AdrianMolecule/inoculatingRobot/documentation/loopHolderParts2.jpg

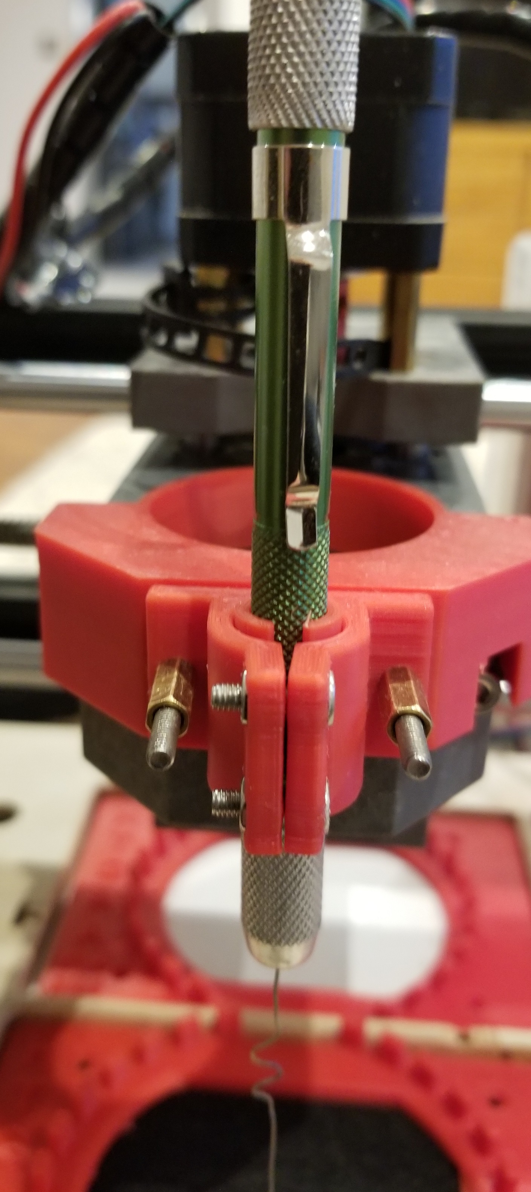
documentation/loopHolderParts2.jpg
