AdrianMolecule/inoculatingRobot/documentation/results/hiResLeafAfterIncubation.jpg

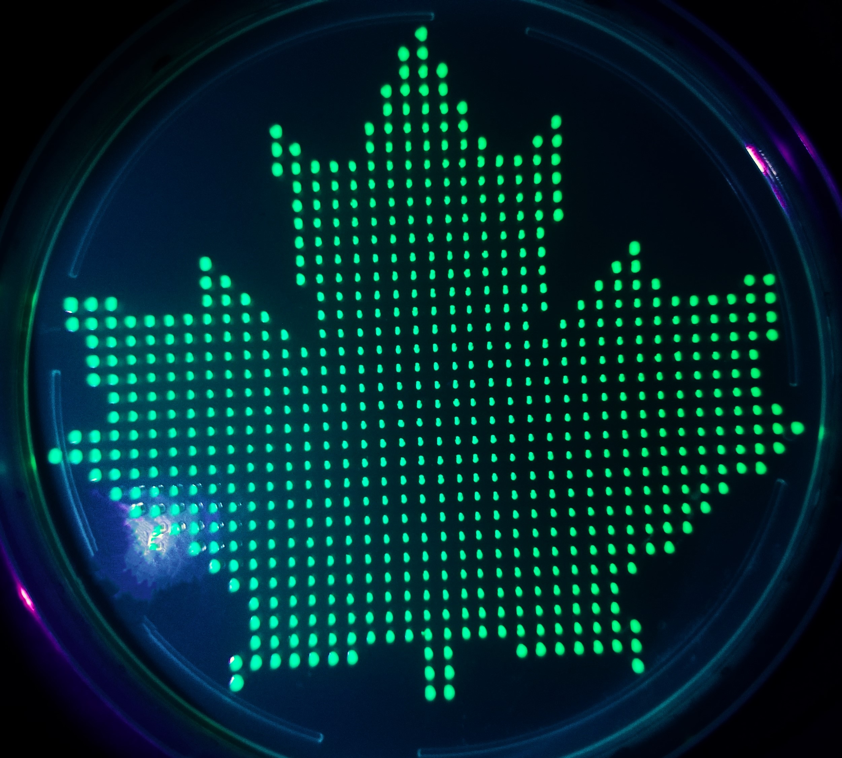
documentation/results/hiResLeafAfterIncubation.jpg
