AdrianMolecule/inoculatingRobot/README.md

# Inoculating Robot
see readme in documentation folder
