AdrianMolecule/inoculatingRobot/documentation/bayFrame.png

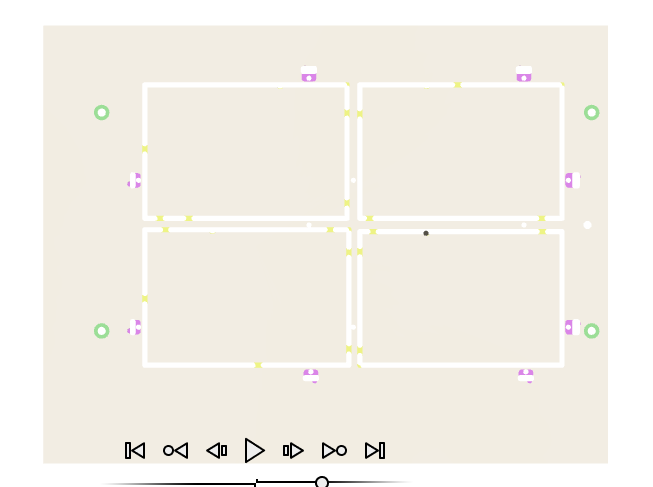
documentation/bayFrame.png
