AdrianMolecule/inoculatingRobot/documentation/bed.png

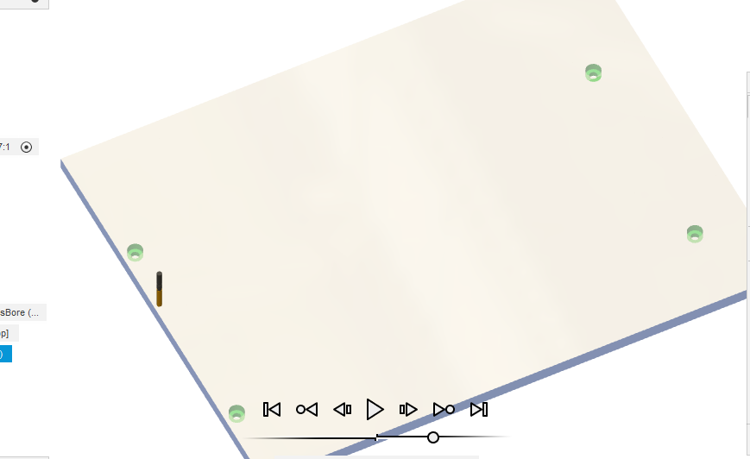
documentation/bed.png
