AdrianMolecule/inoculatingRobot/documentation/dotGeneratorOutput.png

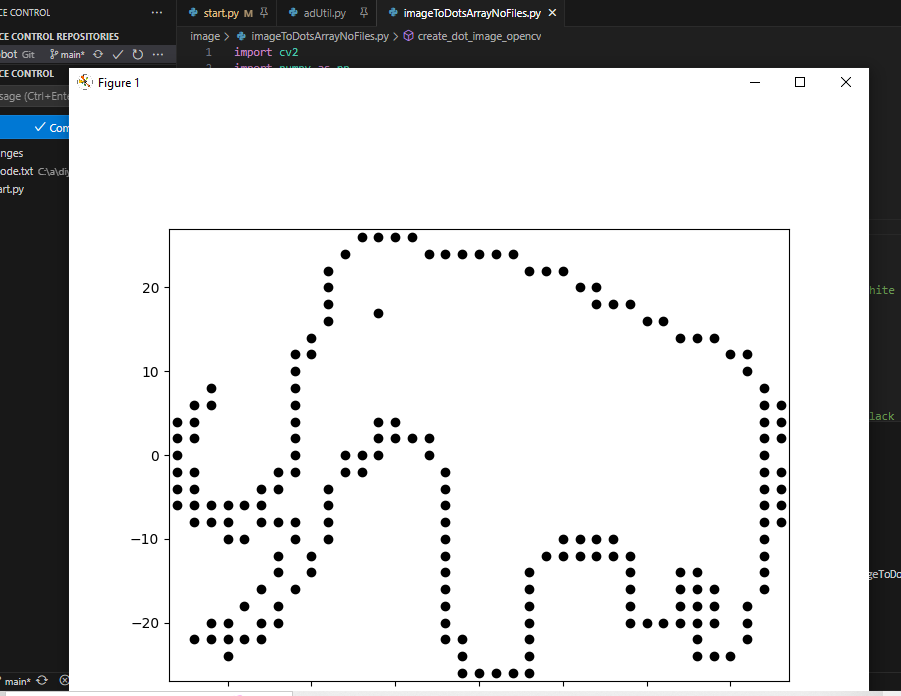
documentation/dotGeneratorOutput.png
