AdrianMolecule/inoculatingRobot/documentation/loopHolder.png

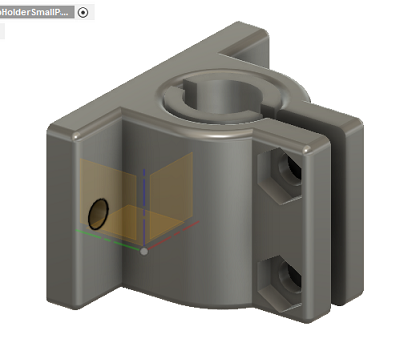
documentation/loopHolder.png
