AdrianMolecule/inoculatingRobot/documentation/StartPyGeneratorVisualOutput.png

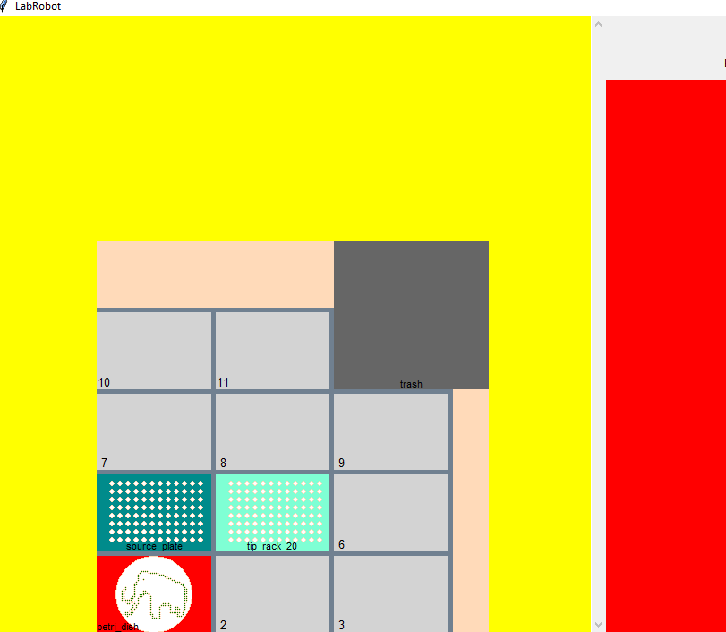
documentation/StartPyGeneratorVisualOutput.png
