AdrianMolecule/inoculatingRobot/documentation/loopHolderParts.jpg

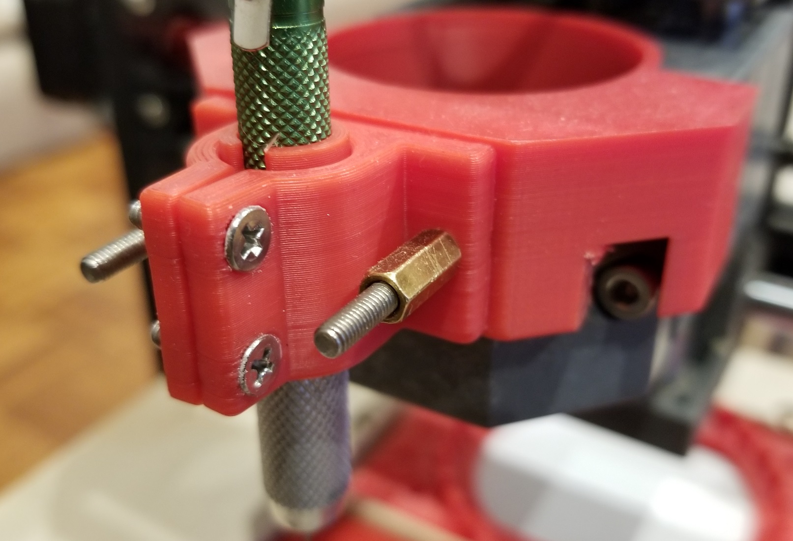
documentation/loopHolderParts.jpg
