AdrianMolecule/inoculatingRobot/documentation/models/petriDishHolderRibsAndClaw v24.stl

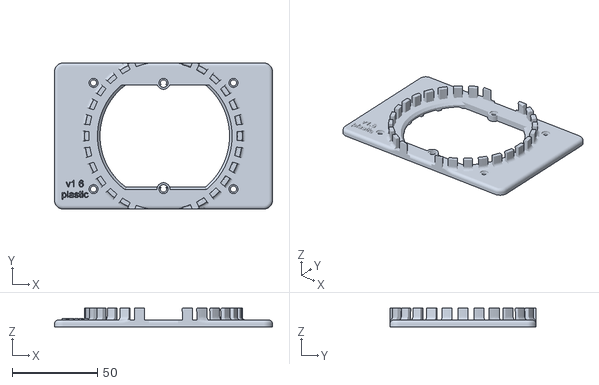
[picture p9: CAD file, 2024-03-27]
documentation/models/petriDishHolderRibsAndClaw v24.stl
127.8 x 85.6 x 11.0
