AdrianMolecule/inoculatingRobot/documentation/models/cncTSlotNutWorks v10.stl

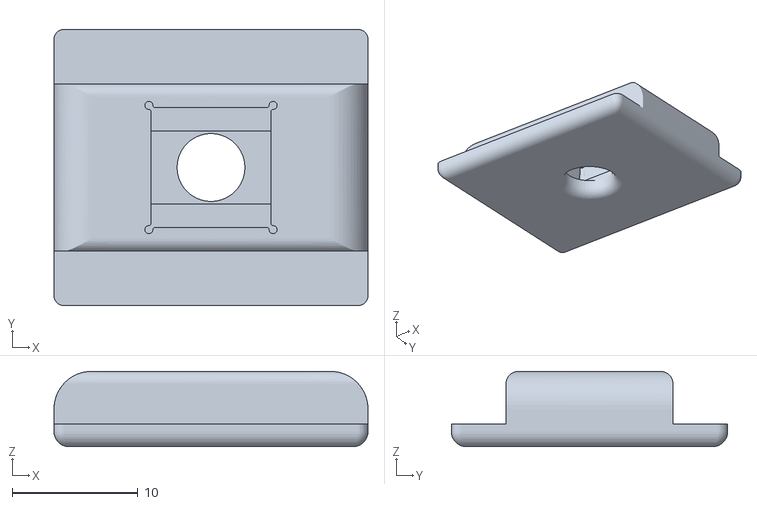
[picture p10: CAD file, 2024-03-27]
documentation/models/cncTSlotNutWorks v10.stl
25.0 x 22.0 x 6.00
