AdrianMolecule/inoculatingRobot/documentation/models/headAttachment3018Cnc v13.stl

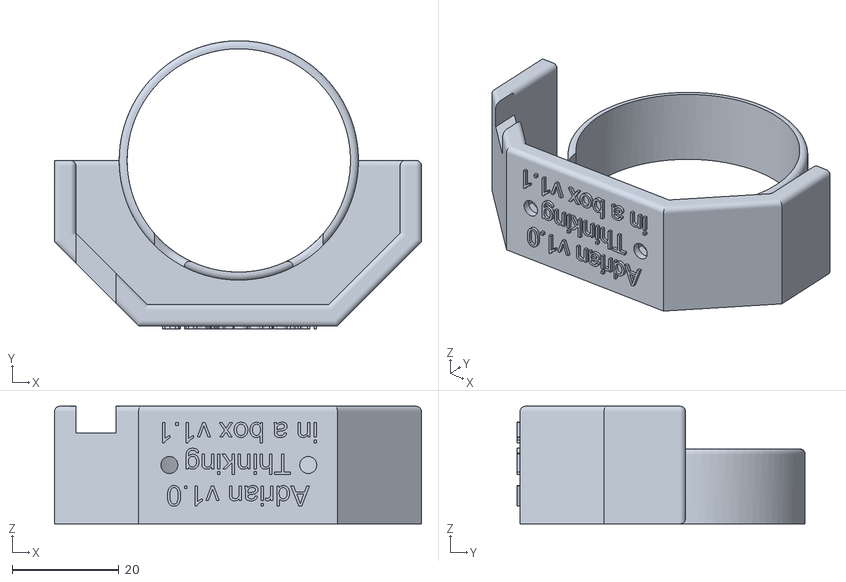
[picture p11: CAD file, 2024-03-27]
documentation/models/headAttachment3018Cnc v13.stl
68.7 x 54.0 x 22.0
