AdrianMolecule/inoculatingRobot/documentation/models/opentronsLoopHolderSmallPartWorking v6.stl

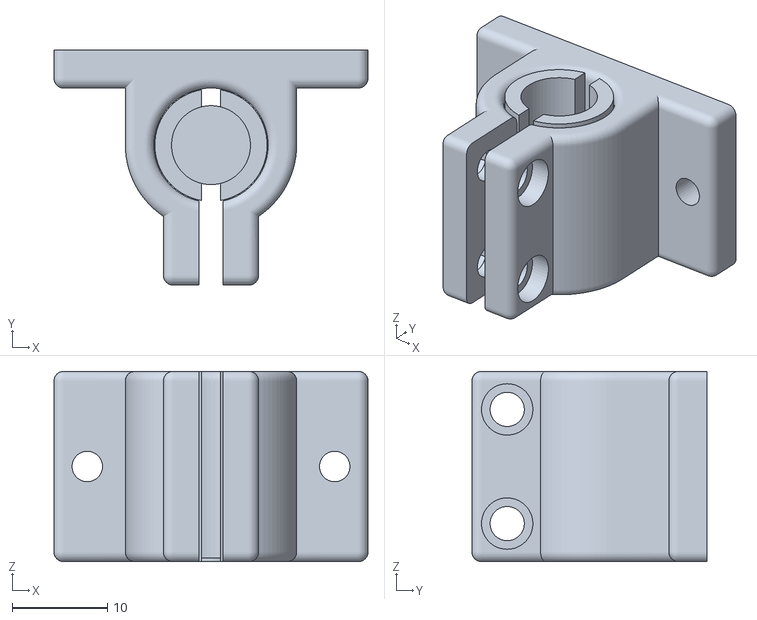
[picture p12: CAD file, 2024-03-27]
documentation/models/opentronsLoopHolderSmallPartWorking v6.stl
33.0 x 24.7 x 20.0
