AdrianMolecule/inoculatingRobot/documentation/models/RobotBedAndFrame.dxf

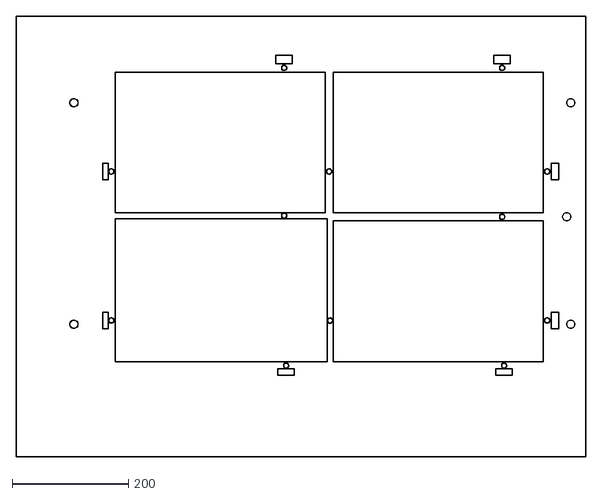
[picture p13: CAD file, 2024-03-27]
documentation/models/RobotBedAndFrame.dxf
980.8 x 759.7
