AdrianMolecule/inoculatingRobot/(list of files, cad)

Other CAD files:
documentation/models/RobotBedAndFrame v49.f3d
documentation/models/cncTSlotNutWorks v10.f3d
documentation/models/headAttachment3018Cnc v13.f3d
documentation/models/opentronsLoopHolderSmallPartWorking v6.f3d
documentation/models/petriDishHolderRibsAndClaw.f3d
