AdrianMolecule/inoculatingRobot/documentation/results/cellularLeaf.jpg

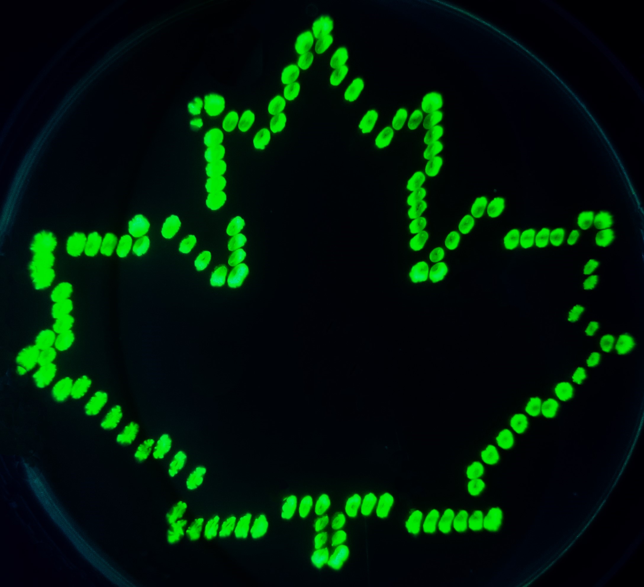
documentation/results/cellularLeaf.jpg
