AdrianMolecule/inoculatingRobot/documentation/results/cellularMamoothAfterIncubation.png

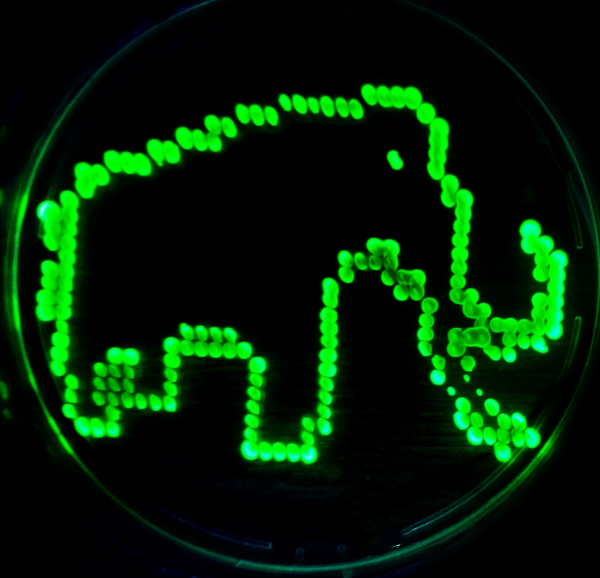
documentation/results/cellularMamoothAfterIncubation.png
