AdrianMolecule/inoculatingRobot/documentation/results/hiResLeafBeforeIncubation.jpg

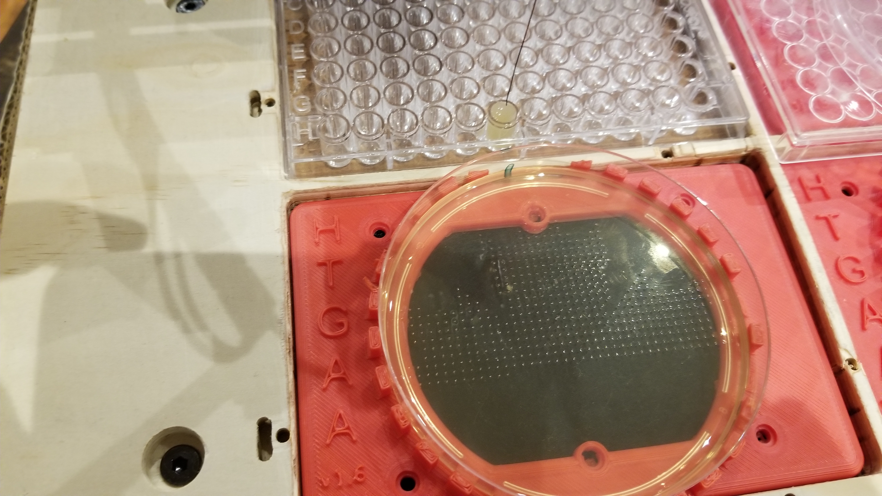
documentation/results/hiResLeafBeforeIncubation.jpg
