AdrianMolecule/inoculatingRobot/documentation/results/leafJustAfterInoculation.jpg

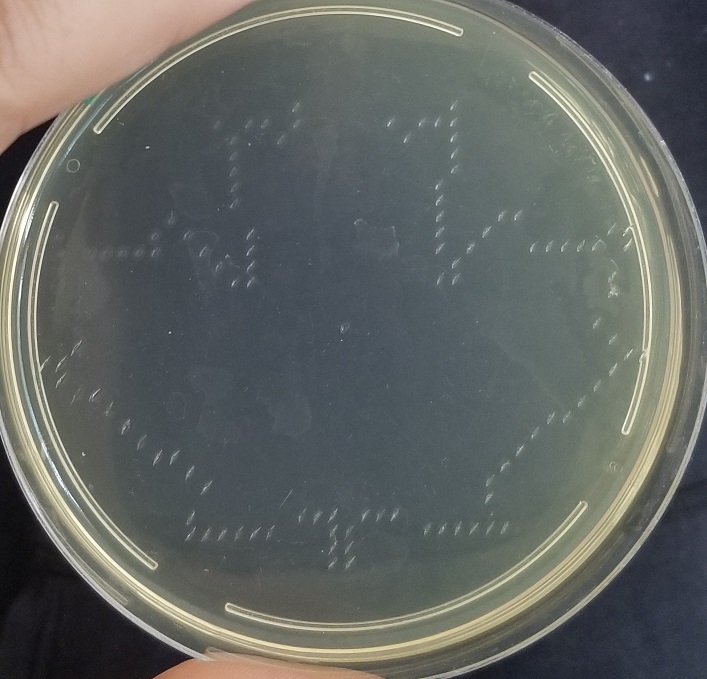
documentation/results/leafJustAfterInoculation.jpg
