AdrianMolecule/inoculatingRobot/documentation/results/mammothRightAfterInoculation.jpg

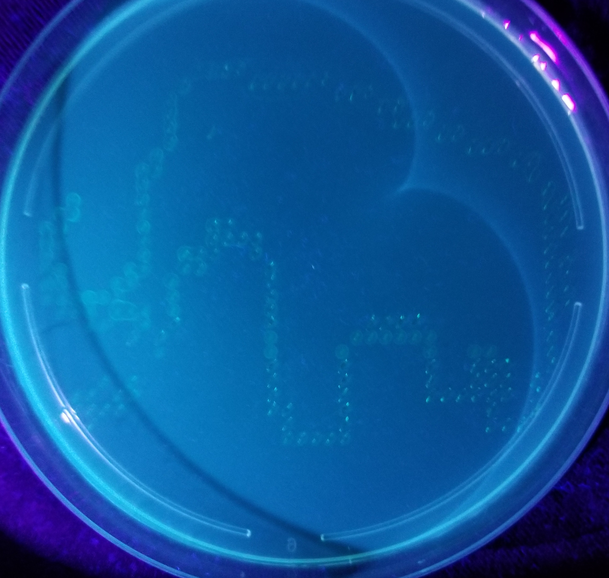
documentation/results/mammothRightAfterInoculation.jpg
