AdrianMolecule/inoculatingRobot/(threads)

Thread 1 (2023-11-03):

start the modeling and  3D printing

AdrianMolecule, 2023-11-03:
There are several items that need to be designed and redesigned until they fit. The loop holders and the Petri dish holder and diverse labware holders.
All have been designed printed and tested.

AdrianMolecule, 2024-03-27:
all done

Closed 2024-03-27.

Thread 2 (2023-11-03):

Understand and take action in regards to the second bug in the microscope files

AdrianMolecule, 2023-11-03:
There is a second 3d file that has errors when one of the variants is used. I need to understand if that is the variant I'm interested in. If not I'll wait for the next build that will correct the issue.

AdrianMolecule, 2023-11-10:
I recontacted via forum the OpenFlexure and a new file was added replacing the condenser lid file that was incorrect.
I printed the new file.

Closed 2023-11-10.

Thread 3 (2023-11-03):

3D printing a first prototype of the standalone microscope

AdrianMolecule, 2023-11-03:
I printed many of the 3d structures.
I did not print the stand and the electronics drawer as I'm not sure they are necessary.
There are a couple of more prints that need to be better understood before attempting.

Thread 8 (2023-11-03):

Test that current version of PyLabRobot is appropriate test/hypothesis template

AdrianMolecule, 2023-11-03:
https://hackmd.io/@Oggo2XIlRZ6wwlsXi_vc8Q/r14-DBZsh/%2F1kONu5gwSS6knAGnwcO5KQ
Step 1: hypothesis
- We believe that a standard inexpensive, mass produced CNC machine is suitable for an inoculating robot<here goes your hypothesis>
- Hypothesis importance (score from 1 to 3)
- Score 3

Step 2: Test
- To verify that, we will.. culture different colonies on a standard 85 mm Petri dish. <here goes your experiment design,
you can also use sketches and images>
- Test cost (from 1 to 3) 2
- Data reliability (score from 1 to 3) 2

Step3: Metric
- And measure..we can seed >100 distinct colonies as close as 2 mm apart without contamination... <what is your core >
- Time required 2+ weeks

Step 4: Criteria
We are right if...we can program the robot using standard software and create and visualize the colonies.. <here goes the criteria that need to be
met for this test to be positive>

Learning documentation

Step 5: Observation
- We observed that ..... there is an OS software that supports many robots. There are some opened issues but it seems robust enough to be used.

Step 6: Learning and insights
- From what we learned that ....https://docs.pylabrobot.org keeps track of dimensions and distances and they can be accessed programmatically.

Step 7:
- Therefore, we will ... <what you will do after capturing this insight, perhaps new prototypes or different types of tests>

AdrianMolecule, 2024-03-27:
It's usable.

Closed 2024-03-27.

Thread 10 (2023-11-10):

Stress test

AdrianMolecule, 2023-11-10:
Test description:
Test that the microscope can function non stop for 2 days

Function to be tested:
Capability to perform for an un-interrupted long period of time

Environment:
.
Full device with a full tray of samples. There can be the same sample repeated.

Test Setup:
Add tray sample support
Add samples to all sockets in the tray
Create a gcode that will take the microscope to take pictures of every image. Put that in a loop that will execute for 10000 times

Test Execution:

Unfocus the microscope and start the gcode execution program
Take pictures of the samples

Expected Results:
All pictures are in focus
The device works un-interrupted for 2 days

Actual Results:
pass / failed

Thread 9 (2023-11-10):

Stress test

AdrianMolecule, 2023-11-10:
Test description:
Test that the microscope can photograph all samples in under 5 minutes.
The sample tray can take 8 large Petri dishes of 90 mm diameter and about 40 small dishes of about 30 mm diameter.

Function to be tested:
Capability to use multiple samples

Environment:
It tells in which environment you are testing.
Full device with a full tray of samples. There can be the same sample repeated.

Test Setup:
Add tray sample support
Add samples to all sockets in the tray
Create a gcode that will take the microscope to take pictures of every image

Test Execution:
It is a detailed description of every step of execution.
Unfocus the microscope and start the gcode execution program
Take pictures of the samples

Expected Results:
All pictures are in focus
Total time is less than 5 minutes for the 40 sample tray

Observe that a similar image of the same slide taken by another microscope appear to be at thesame resolution

Actual Results:
pass / failed

If pass - What actually happens when you run the test?

If failed - put in the description of what you've observed.

Exercise 3 (optional): Design a test bench for those tests that you think you need to perform several times

Instructions
